junkbotix/build-a-follow-me-robot/chassis-electrical/README.md

Junkbotix Banner

<br>

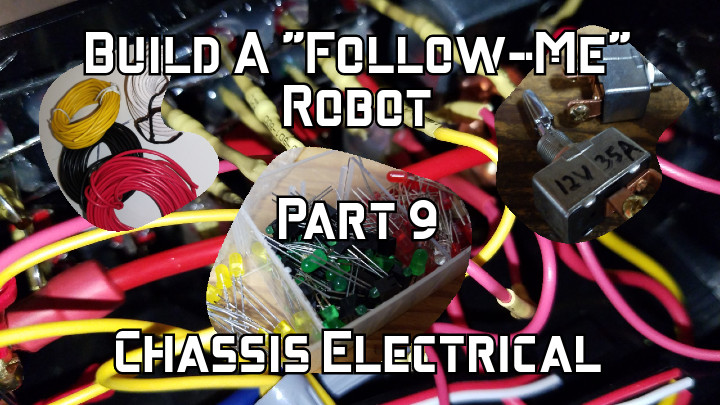
[picture p3: chassis-electrical/images/chassis-electrical-720px.jpg]
Part 9 (https://www.youtube.com/watch?v=LijISf1I_SE)


Check out the latest on this project and other tutorials at the [Junkbotix Channel](https://www.youtube.com/channel/UCNxQ47xBEYjD-mey_lxj9Aw) on Youtube!

<br>

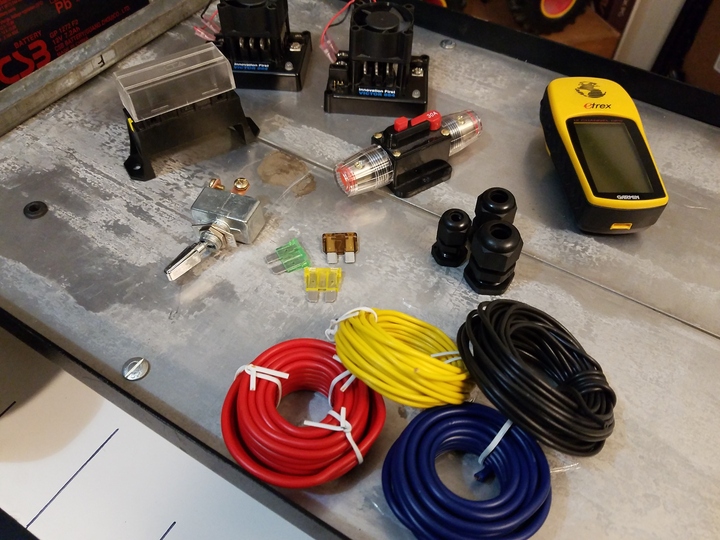
[picture p4: chassis-electrical/images/parts-720px.jpg]
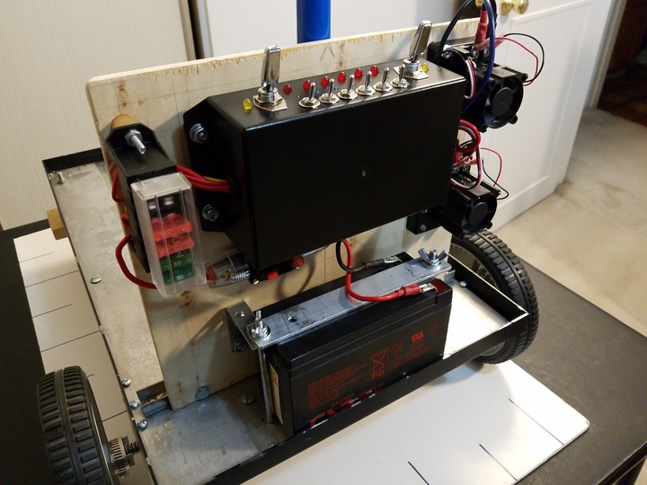
[picture p5: chassis-electrical/images/completed-720px.jpg]
&nbsp;&nbsp;&nbsp;&nbsp;

<br>

Once you have your robot chassis built, you'll need a source of electricity, and ideally a way to control it. Having such a system in place will allow you to more easily develop and maintain the robot's software, while also keeping things neat and tidy, which will help in future maintenance.

But to build such a system, you'll need to plan, design and fabricate it accordingly. How you plan your robot's electrical needs is just as important as its mechanicals, electronics, and code needs. Without a cohesive plan, you might end up with a messy entanglement of wires and tape, making future changes or fixes difficult.

Planning involves coming up with a layout of your electrical system and needs, along with understanding what sub-systems you need to supply power to, and what their voltage and current needs will likely be. How your chassis is built will help determine how you route wiring, and place circuit boards and other parts (indeed, during the design and fabrication of your chassis, you will also need to keep in mind the eventual electrical plan).

This may all sounds like a "chicken-and-egg" problem, but it doesn't have to be. You can design your electrical system first, and then design and fabricate a chassis around that. Or, you can have a rough idea of what you'll later need, and keep it in mind as you build your chassis. You may later need to alter your electrical plans, or even your chassis, but usually, if you have a fairly solid idea in place, any deviations will likely be minor.

## Quicklinks

* [Layout](./layout)
* [Parts](./parts)
  * [Battery](./parts/battery)
  * [Breaker and Fuses](./parts/fuses)
  * [Switches](./parts/switches)
  * [Indicators](./parts/indicators)
  * [Motor Controllers](./parts/motor-controllers)
* [Mechanical](./mechanical)
  * [Panel](./mechanical/panel)
  * [Enclosure](./mechanical/enclosure)
  * [Beacon Support Pole](./mechanical/beacon-pole)
  * [Battery Strap](./mechanical/battery-strap)
* [Wiring](./wiring)

<br>

## Layout
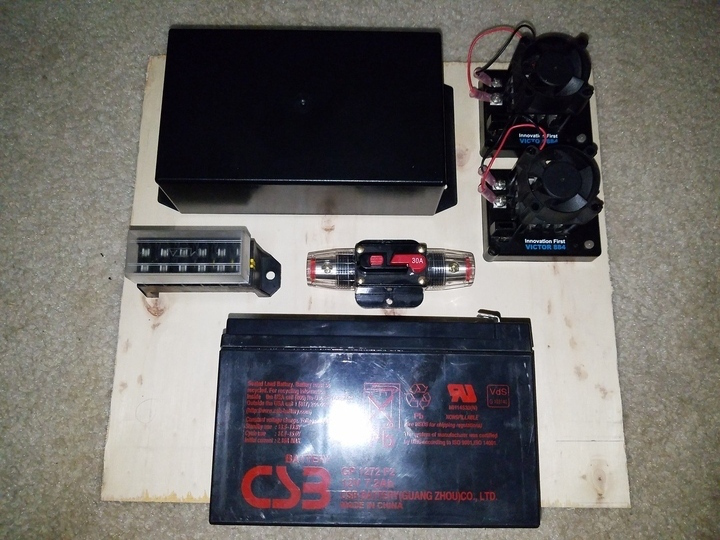
[picture p6: chassis-electrical/layout/images/battery-placement-720px.jpg]
[](./layout)

## Battery (12 VDC, 7Ah)
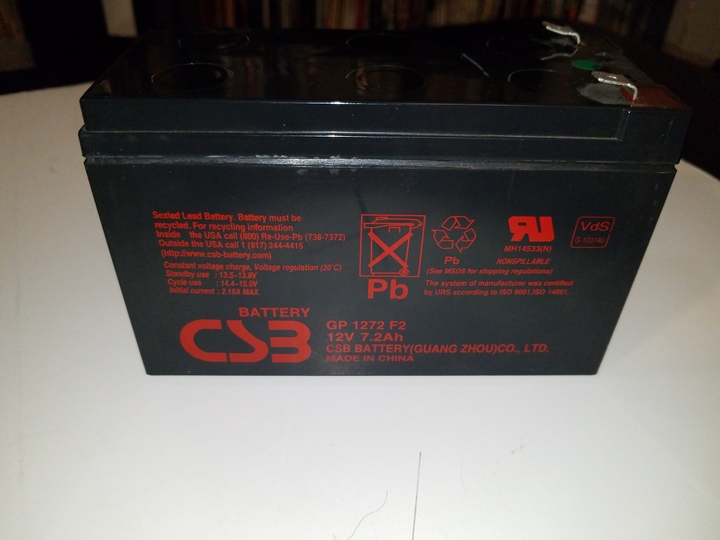
[picture p7: chassis-electrical/parts/battery/images/battery-720px.jpg]
[](./parts/battery)

## Breaker (30A) and Fuses
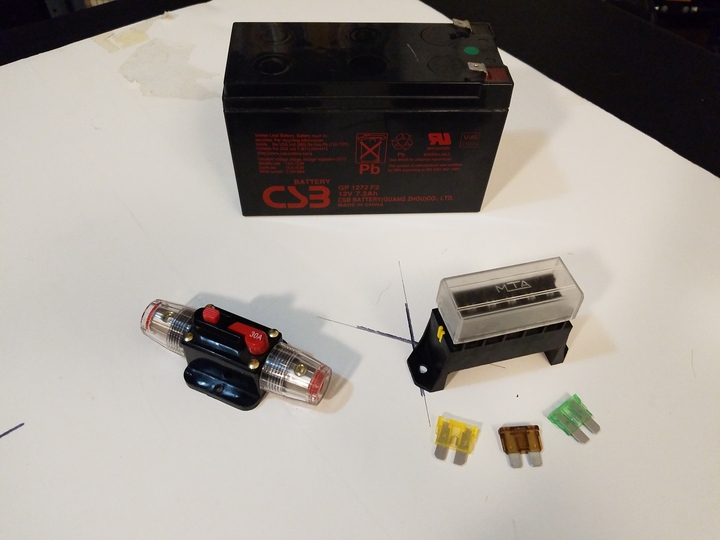
[picture p8: chassis-electrical/parts/fuses/images/breaker-fuses-battery-720px.jpg]
[](./parts/fuses)

## Switches
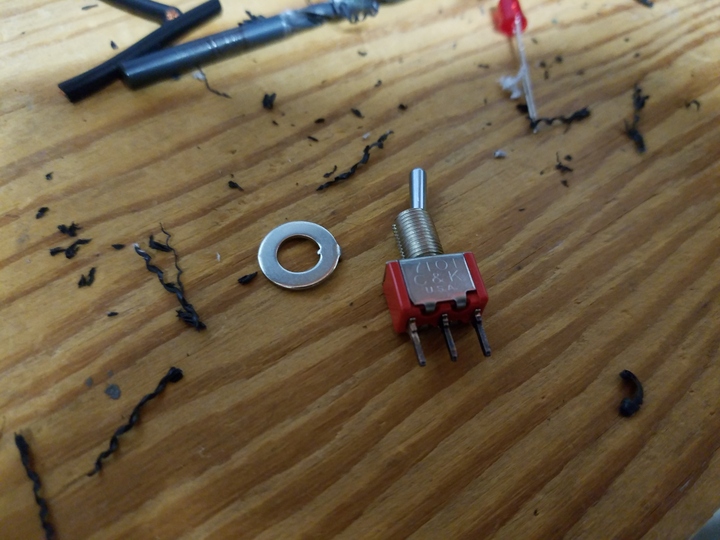
[picture p9: chassis-electrical/parts/switches/images/small-switch-720px.jpg]
[](./parts/switches)

## Indicators
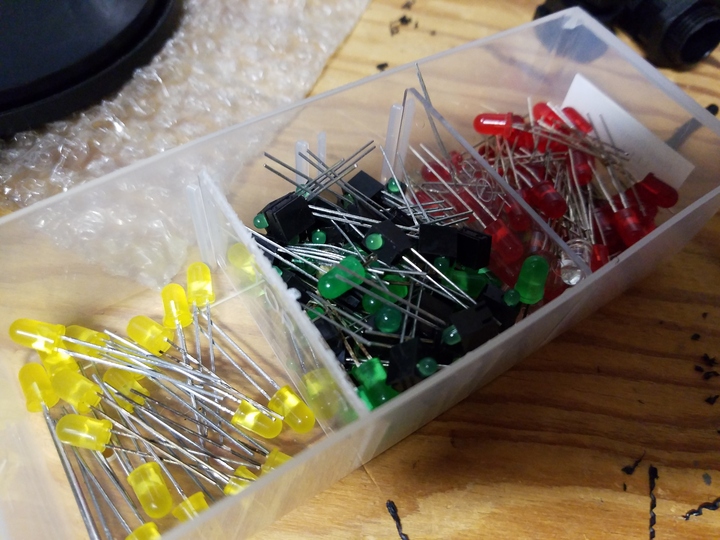
[picture p10: chassis-electrical/parts/indicators/images/leds-720px.jpg]
[](./parts/indicators)

## Motor Controllers
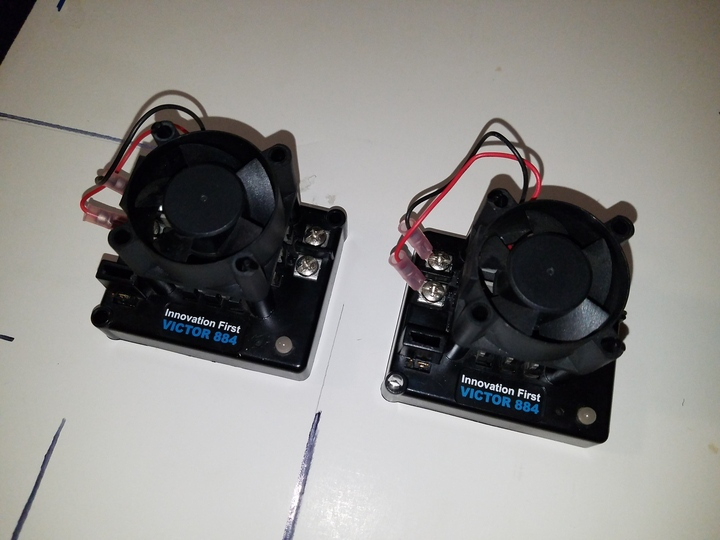
[picture p11: chassis-electrical/parts/motor-controllers/images/motor-controllers-720px.jpg]
[](./parts/motor-controllers)

## Panel
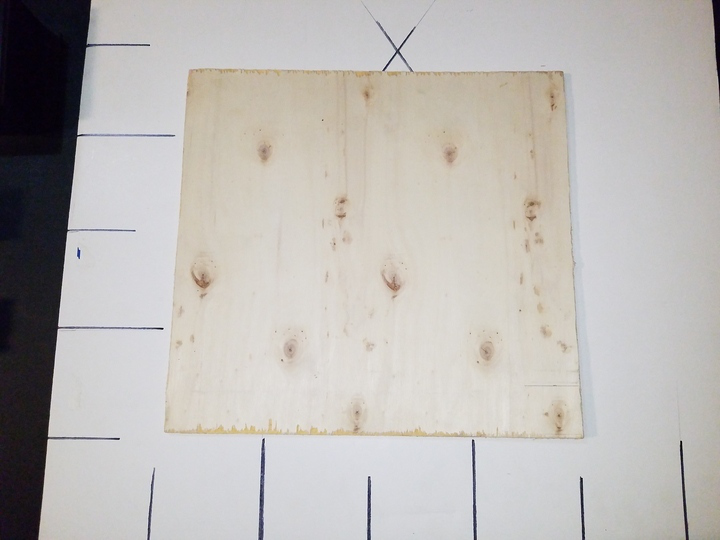
[picture p12: chassis-electrical/mechanical/panel/images/panel-720px.jpg]
[](./mechanical/panel)

## Enclosure
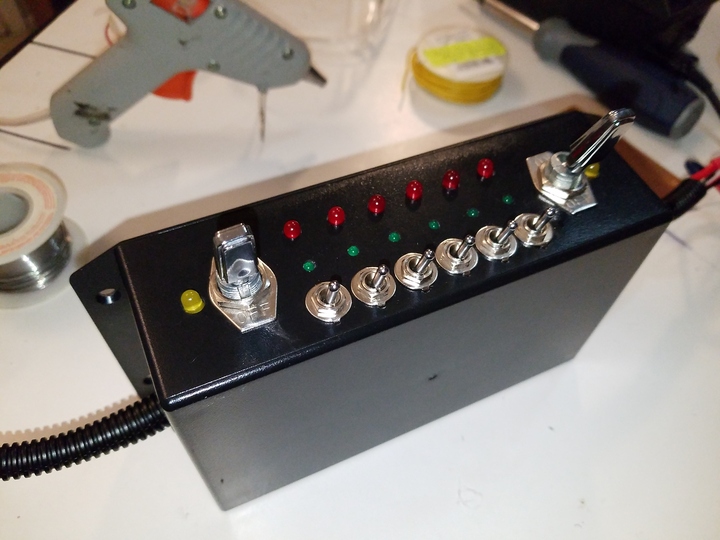
[picture p13: chassis-electrical/mechanical/enclosure/images/completed-enclosure-720px.jpg]
[](./mechanical/enclosure)

## Beacon Support Pole
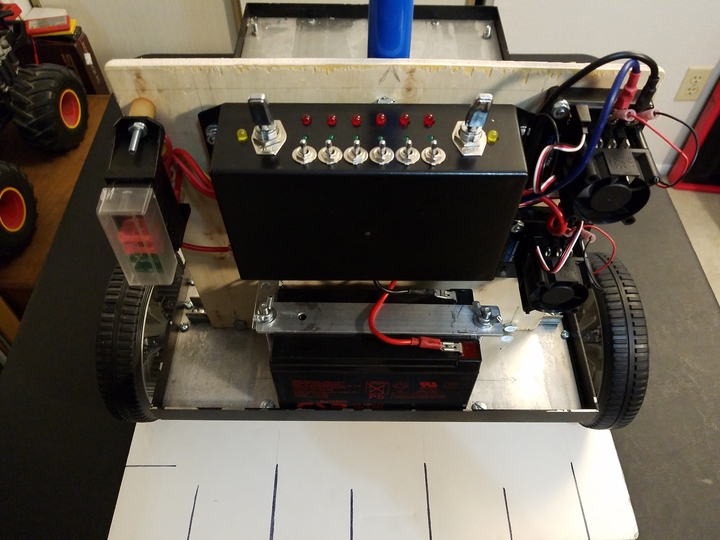
[picture p14: chassis-electrical/mechanical/beacon-pole/images/complete-system-2-720px.jpg]
[](./mechanical/beacon-pole)

## Battery Strap
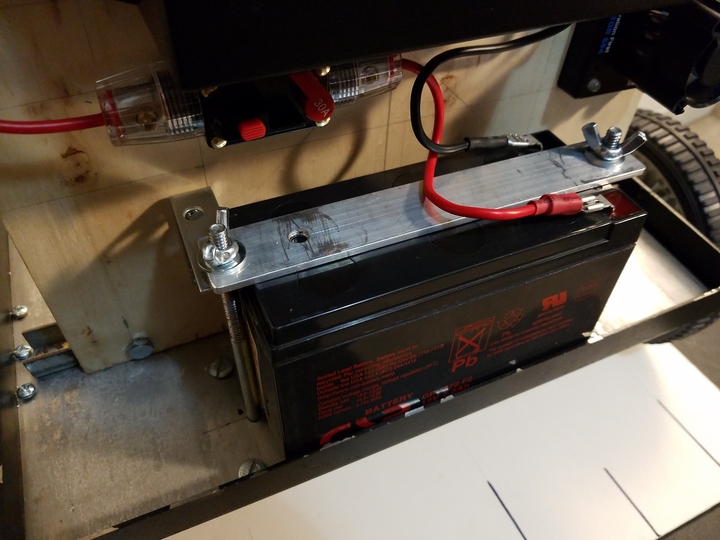
[picture p15: chassis-electrical/mechanical/battery-strap/images/battery-strap-2-720px.jpg]
[](./mechanical/battery-strap)

## Wiring
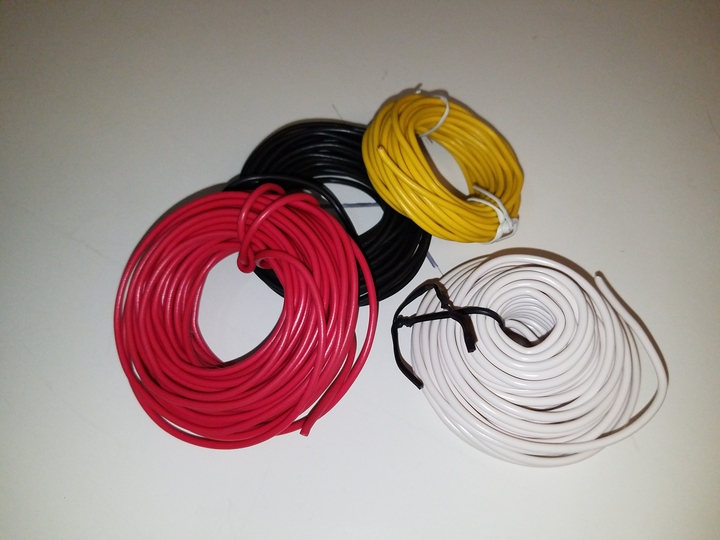
[picture p16: chassis-electrical/wiring/images/16awg-wire-720px.jpg]
[](./wiring)
