junkbotix/build-a-follow-me-robot/motor-control/README.md

Junkbotix Banner

<br>

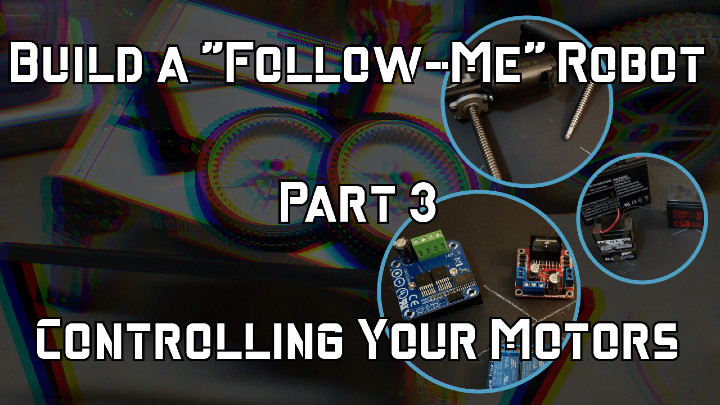
[picture p47: motor-control/images/controlling-motors-720px.jpg]
Part 3 (https://www.youtube.com/watch?v=zeTaibkZ3Tk)


Check out the latest on this project and other tutorials at the [Junkbotix Channel](https://www.youtube.com/channel/UCNxQ47xBEYjD-mey_lxj9Aw) on Youtube!

<br>

## H-Bridges

Useful when direct control of speed and direction of your motor is needed.
<br>

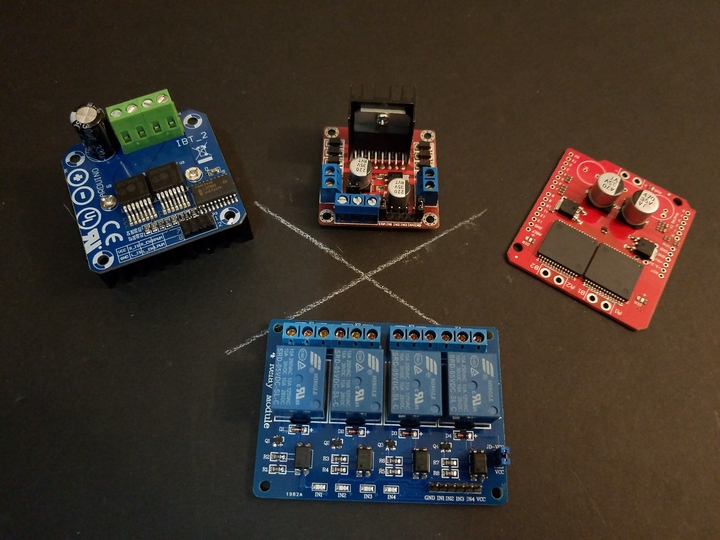
[picture p48: motor-control/h-bridges/images/hbridge-modules-720px.jpg]
H-Bridge Modules
<br>[Various H-Bridge Modules](./h-bridges)

<br>

## RC Electronic Speed Controllers (ESC)

Used when you need or want to use RC (radio control) signals to control your motors, and add a degree of "intelligence", depending on the ESC used.
<br>

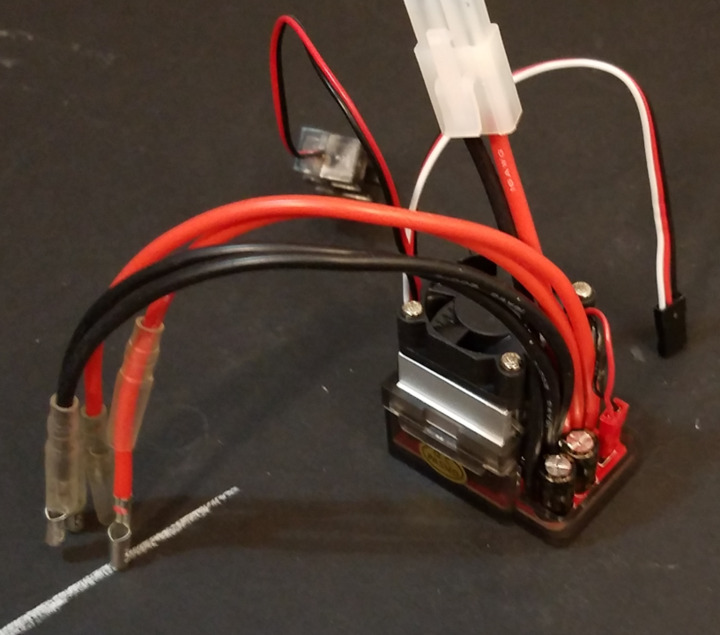
[picture p49: motor-control/esc/images/rc-esc-720px.jpg]
RC ESC
<br>[RC Electronic Speed Controllers (ESC)](./esc)

<br>

## Generic DC Motor Reversible Speed Controller

This kind of controller needs hacking to be useful, but it is inexpensive and powerful.
<br>

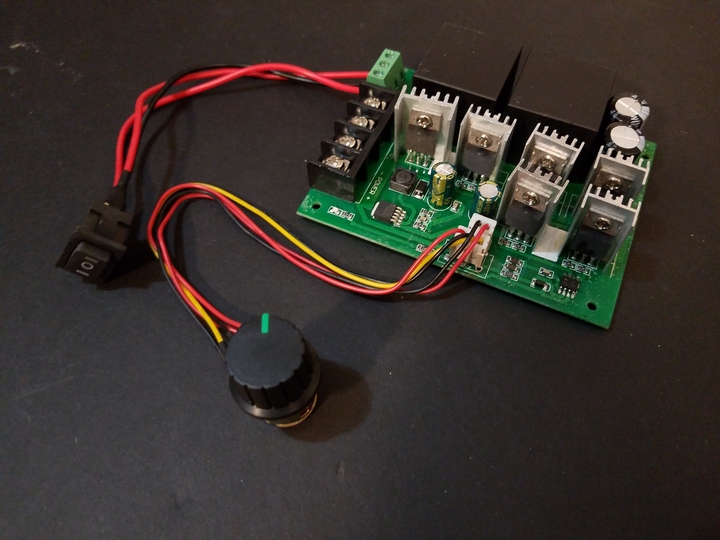
[picture p50: motor-control/generic-controller/images/generic-controller-720px.jpg]
Generic Controller
<br>[Generic DC Motor Controller](./generic-controller)

<br>

## Motor Controllers

If more intelligence is needed, these FRC (FIRST Robotics) controllers can fit the bill; in addition RC PPM/PWM for control, the Jaguar controller can be interfaced using RS-232 and/or CAN over a serial bus, which can be daisy-chained, reducing the number of wires and pins needed for control.
<br>

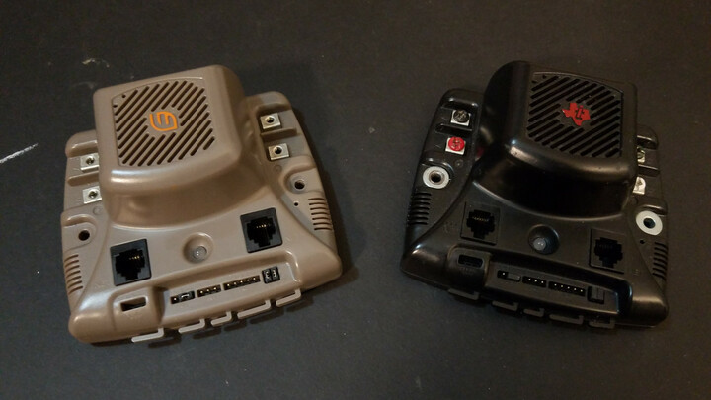
[picture p51: motor-control/jaguar/images/jaguar-controllers-720px.jpg]
MDL-BDC
<br>[MDL-BDC(24) Jaguar (FRC)](./jaguar)

<br>

The Victor-884 and 888 controllers are closer to ruggedized RC ESC controllers, and can't be daisy-chained. Less intelligence, but easier to configure.
<br>

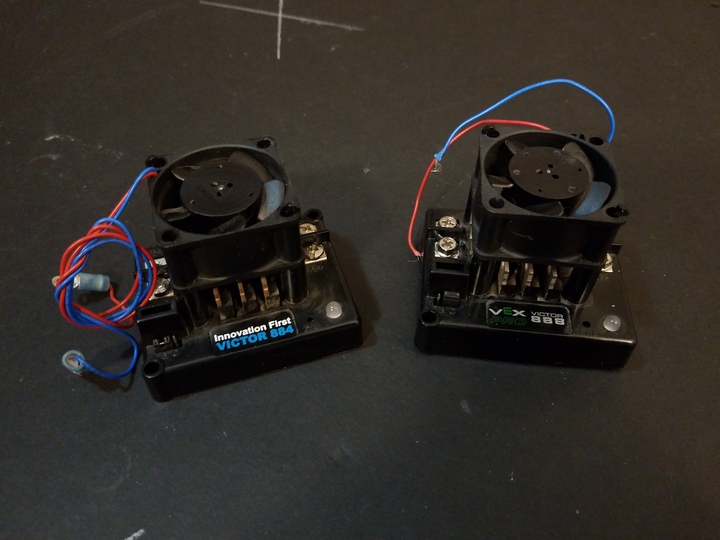
[picture p52: motor-control/victor-884-888/images/victor-884-888-720px.jpg]
Victor-884-888
<br>[Victor-884 and 888 (FRC)](./victor-884-888)
