junkbotix/build-a-follow-me-robot/motor-control/victor-884-888/README.md

Junkbotix Banner

<br>

## Victor-884 and 888 (FRC)

Victor-884 and 888

<br>

The Victor-884 and 888 controllers are closer to ruggedized RC ESC controllers, and can't be daisy-chained. Less intelligence, but easier to configure.

* [IFI Victor-884 Users Manual](./manuals/IFI-Victor-884-Users-Manual.pdf)
* [VexPro Victor-888 User Manual](./manuals/VexPro-Victor-888-User-Manual.pdf)

Like the Jaguar controllers, these are now discontinued, but can also be found sold on the secondary market.

<br>

## More Information

More information about these controllers can be found at [the FIRSTwiki](https://firstwiki.github.io/wiki/victor-884).
