junkbotix/build-a-follow-me-robot/chassis-electrical/mechanical/panel/README.md

Junkbotix Banner

<br>

&nbsp;&nbsp;&nbsp;&nbsp;&nbsp;&nbsp;&nbsp;&nbsp;

Check out the latest on this project and other tutorials at the [Junkbotix Channel](https://www.youtube.com/channel/UCNxQ47xBEYjD-mey_lxj9Aw) on Youtube!

<br>

## The Panel

The purpose of the panel is to ultimately hold all of these parts:

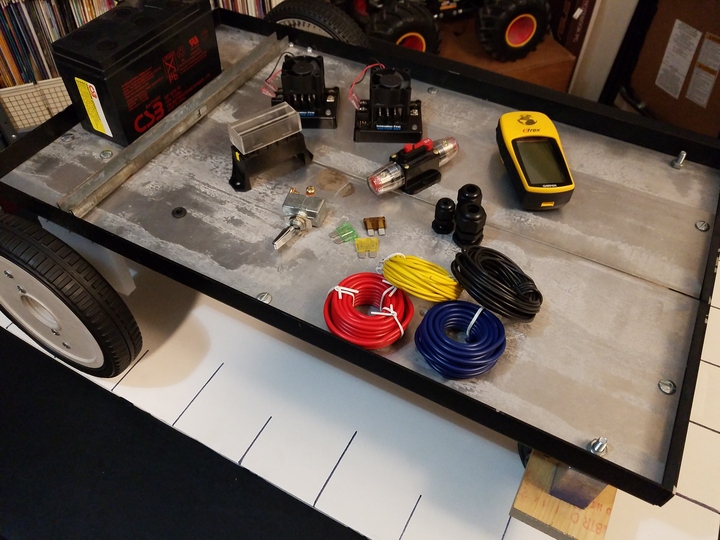
[picture p98: chassis-electrical/mechanical/panel/images/parts-720px.jpg]
Parts


...and others, vertically and out of the way of the cargo area of the chassis. The panel is mounted vertically, between the steel motor bracket bar at the rear of the chassis, and the battery. The beacon support pole, standing vertically from the center of the motor bracket bar, helps to stabilize the panel (while keeping the pole from tipping to the side).

<br>

## The Electrical Bits

The battery is connected to a 30 amp breaker, which is then connected to a fuse block:

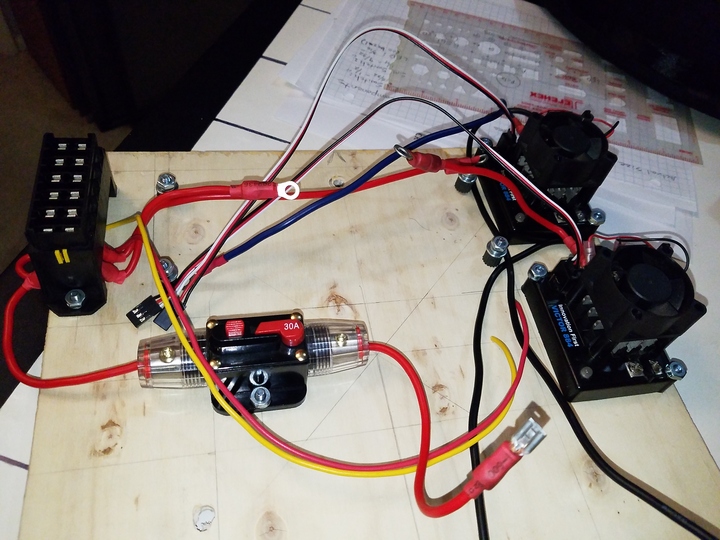
[picture p99: chassis-electrical/mechanical/panel/images/panel-wiring-720px.jpg]
Power Wiring


Please see the section on [wiring](../../wiring) for more details...

<br>

## Final Results

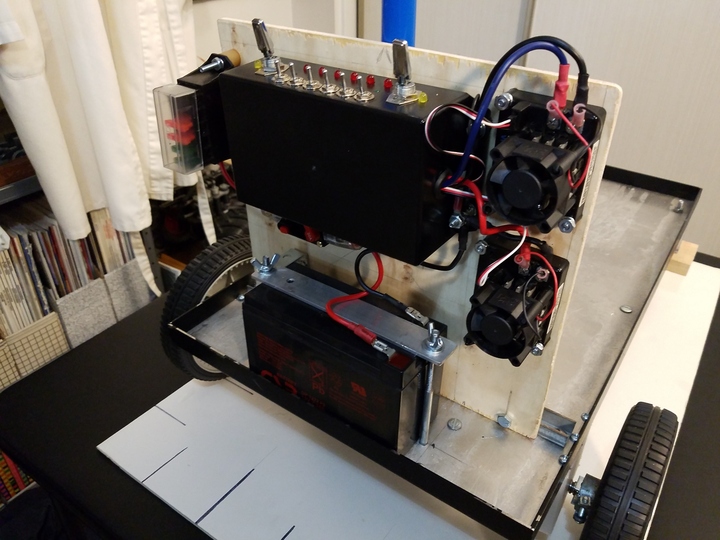
[picture p100: chassis-electrical/mechanical/panel/images/complete-system-2-720px.jpg]
&nbsp;&nbsp;&nbsp;&nbsp;
