junkbotix/build-a-follow-me-robot/motor-control/h-bridges/relay-bridge/README.md

Junkbotix Banner

<br>

## Relay Bridges

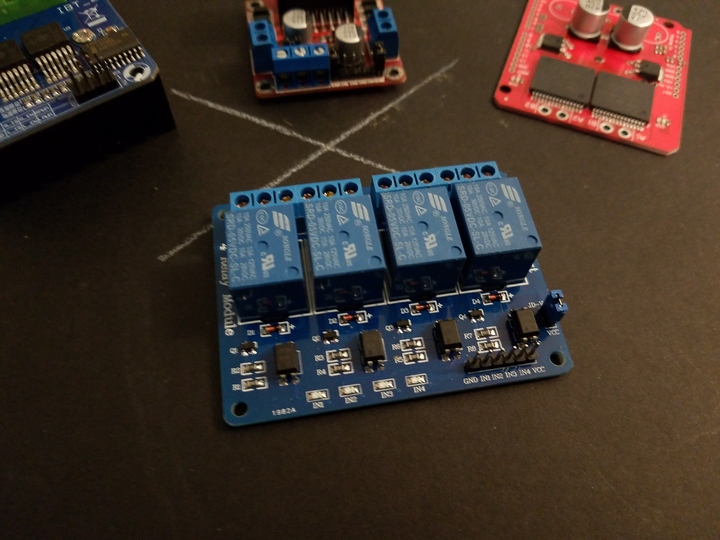
[picture p105: motor-control/h-bridges/relay-bridge/images/relay-module-720px.jpg]
Relay Module


<br>

These relay modules are also widely available and inexpensive. They come in a variety of configurations, having 1, 2, 4, or 8 relays. Each relay is usually a 10A SPDT. Some boards, like this one, are opto-isolated (and as such, usually can be used with 3.3v TTL outputs, too). But not all are.

<br>

## Schematic

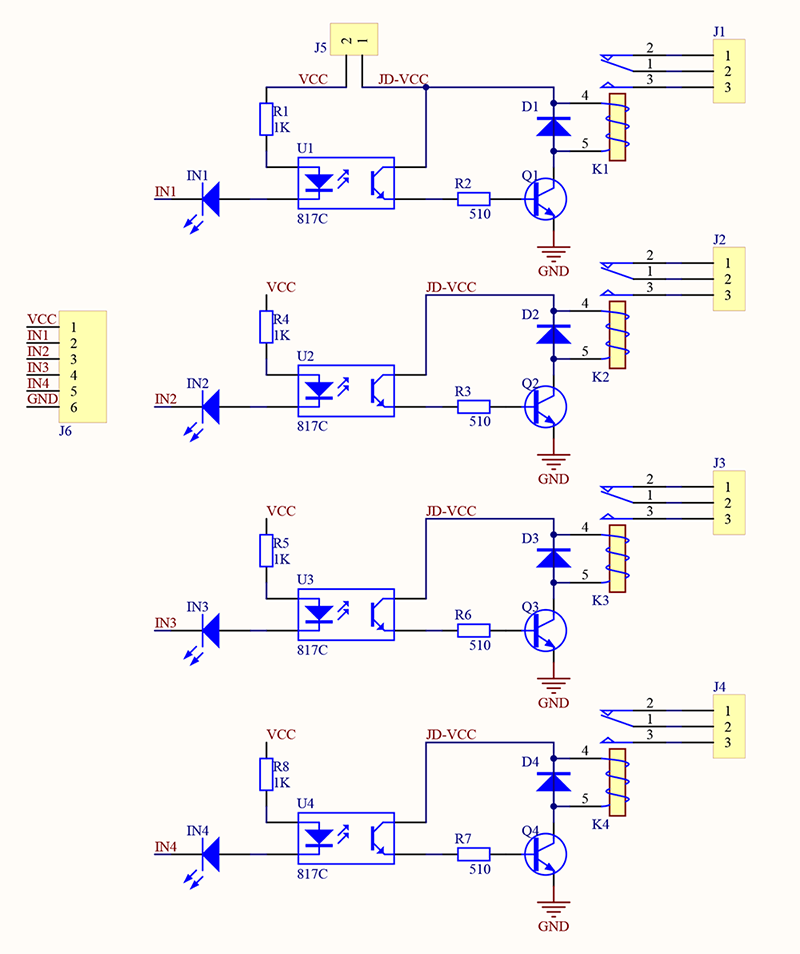
[picture p106: motor-control/h-bridges/relay-bridge/files/4_channel_relay_schematic.png]
4 channel relay module schematic


<br>

## Relay H-Bridge

A pair of the relays can be used to build a simple and controllable h-bridge:

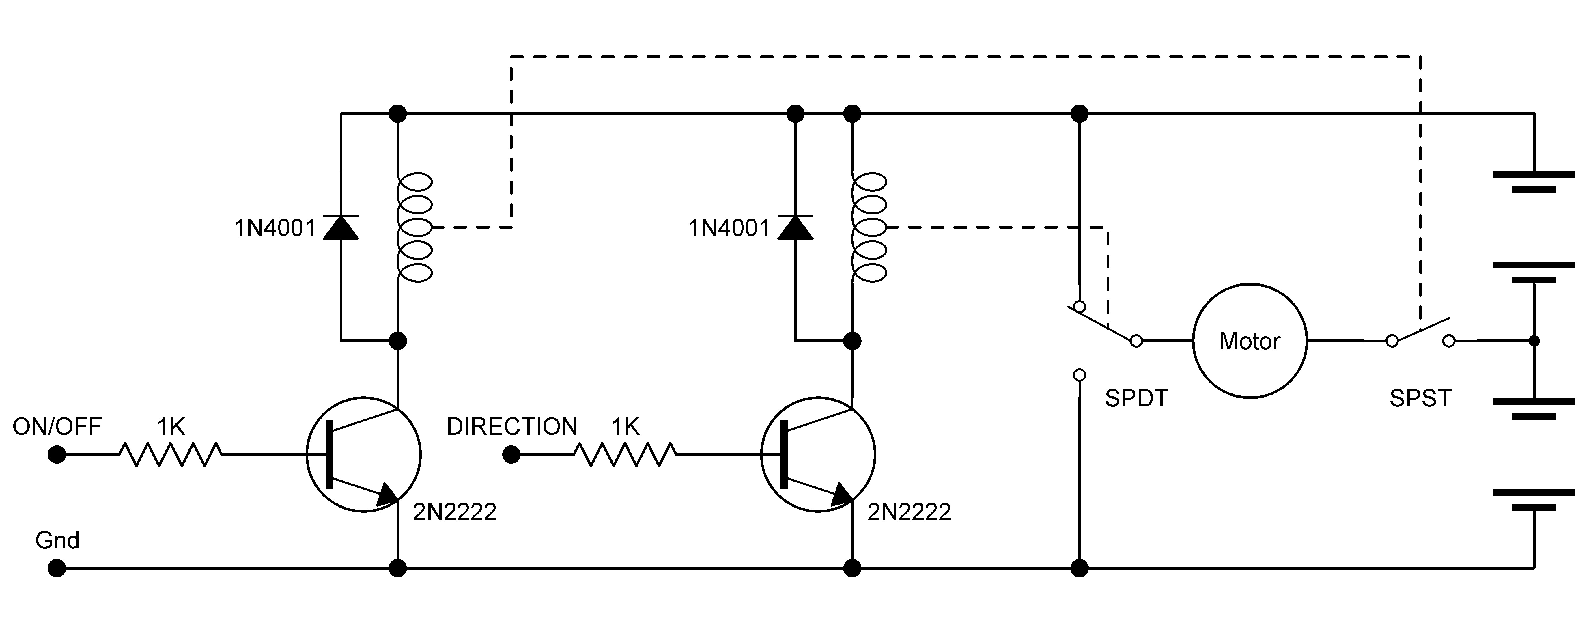
[picture p107: motor-control/h-bridges/relay-bridge/files/bridge-relay-2.jpg]
Transistor Control
<br>
Note the dual-ended motor power supply in the above schematic; compare it with the following (which is also opto-isolated):

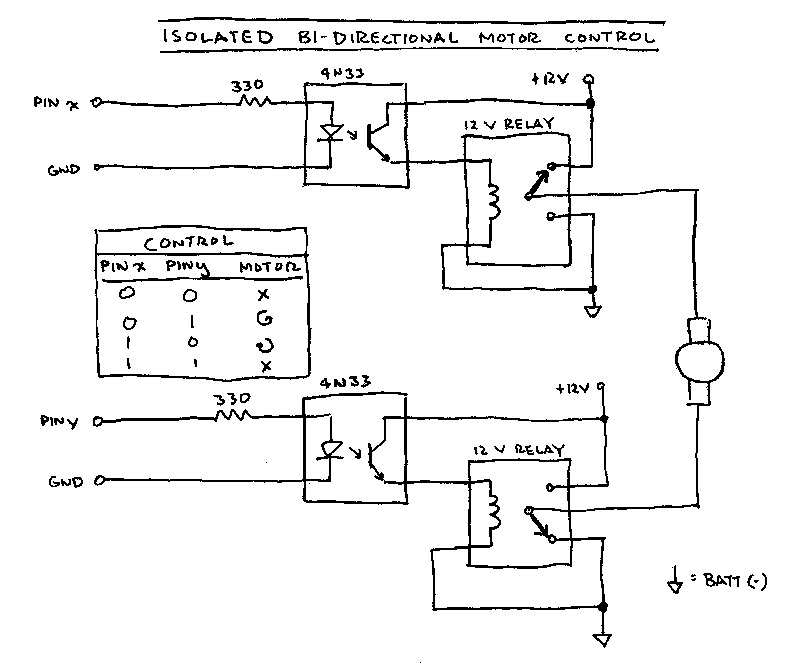
[picture p108: motor-control/h-bridges/relay-bridge/files/isolated-bi-directional-motor-control.jpg]
Opto-Isolator Control


<br>

## Using Bosch Relays

It might also be possible to desolder the relays from such a relay module, and replace them with pairs of Bosch automotive relays, for greater current handling:

Bosch SPDT Relay<br>
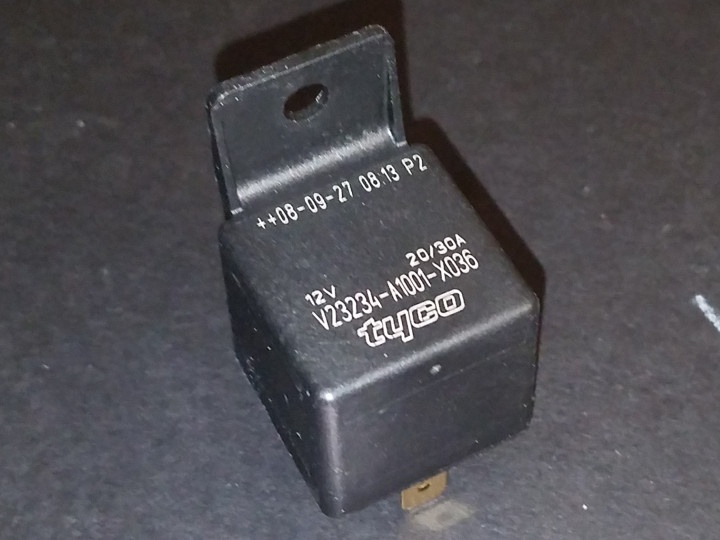
[picture p109: motor-control/h-bridges/relay-bridge/files/bosch-relay-720px.jpg]
Bosch SPDT Relay


Bosch SPDT Relay Pinout<br>
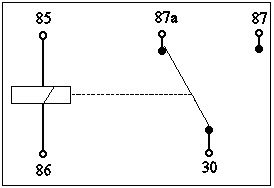
[picture p110: motor-control/h-bridges/relay-bridge/files/bosch-spdt-relay-pinout.jpg]
Bosch SPDT Relay Pinout


Motor Control<br>
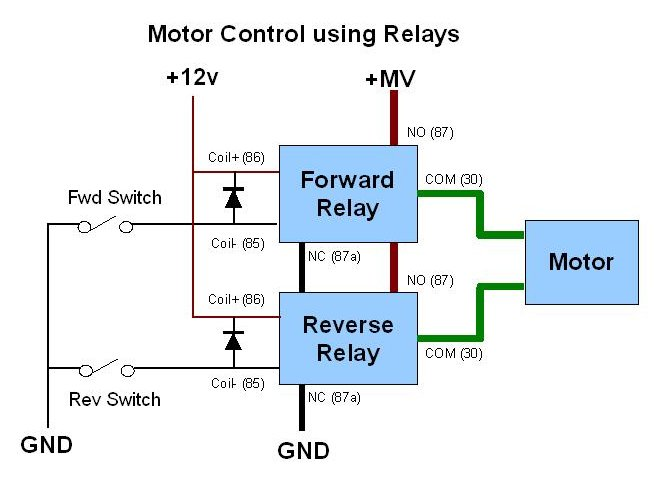
[picture p111: motor-control/h-bridges/relay-bridge/files/bosch-relay-motor-control.jpg]
Bosch SPDT Relay Motor Control


Alternatively, you can just replace the switches with transistors, as before, to control the relays.

<br>

## MOSFET Speed Control (hybrid bridge)

A mosfet can also be used on the low-side of the bridge to control the speed of the motor:

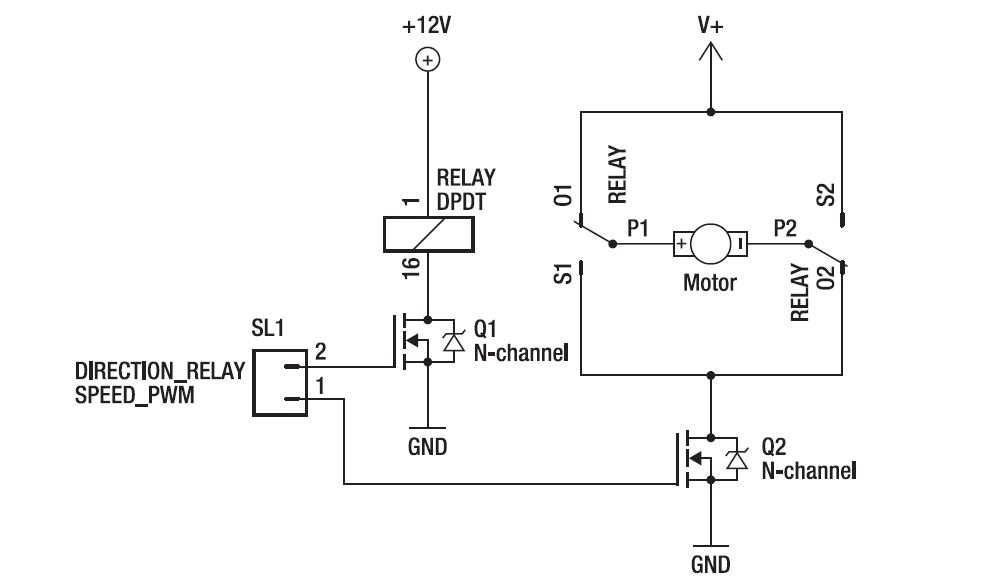
[picture p112: motor-control/h-bridges/relay-bridge/files/dpdt-h-bridge.jpg]
MOSFET Control


Note that this schematic shows a DPDT relay being used, but it isn't common to find such relays with high-current carrying contacts, which is why pairs of SPDT relays are usually used.
