junkbotix/build-a-follow-me-robot/motor-control/jaguar/ti-mdl-bdc24/README.md

Junkbotix Banner

<br>

## Texas Instruments MDL-BDC24 Black Jaguar (FRC)

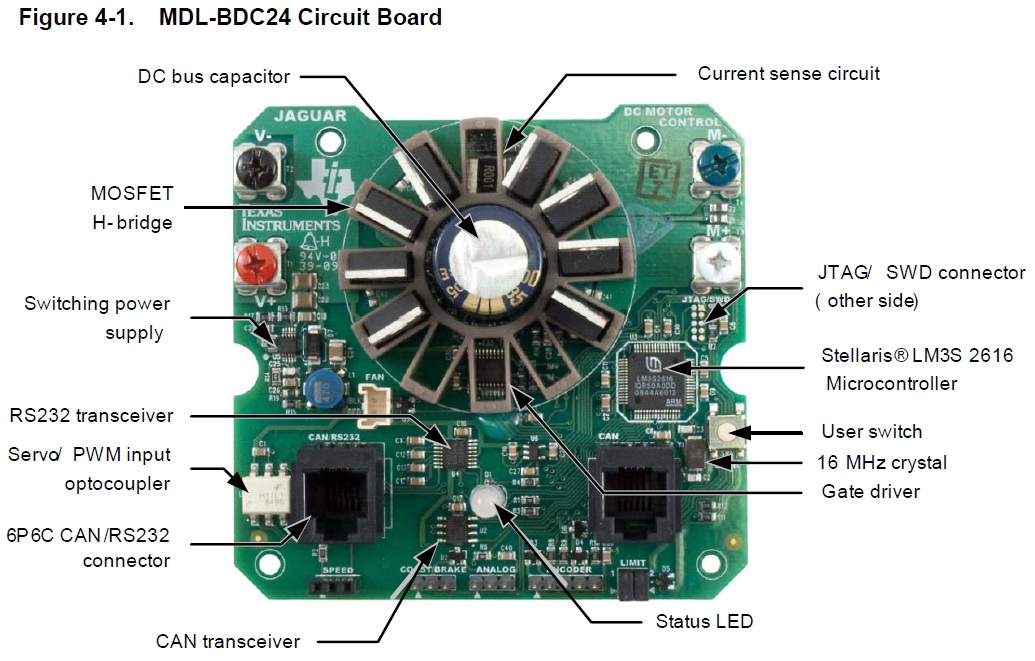
[picture p113: motor-control/jaguar/ti-mdl-bdc24/internals/mdl-bdc24-pcb-parts-layout.jpg]
MDL-BDC


<br>

### Documentation

* [Product Brief (Rev A)](./manuals/mdl-bdc24-product-brief-rev-a.pdf)
* [Datasheet (Rev C)](./manuals/mdl-bdc24-datasheet-rev-c.pdf)
* [Getting Started Guide](./manuals/mdl-bdc24-getting-started-guide.pdf)
* [Users Manual](./manuals/mdl-bdc24-users-manual.pdf)

<br>

### Schematics

* [Embedded Controller, RS-232, CAN](./internals/mdl-bdc24-full-schematic-1.png)
* [Power Supply and H-Bridge](./internals/mdl-bdc24-full-schematic-2.png)
