junkbotix/build-a-follow-me-robot/software/esp32/FMController/README.md

Junkbotix Banner

Check out the latest on this project and other tutorials at the [Junkbotix Channel](https://www.youtube.com/channel/UCNxQ47xBEYjD-mey_lxj9Aw) on Youtube!

<br>

## Controller Firmware for the Junkbotix Build A "Follow-Me" Robot

* [FMController.h](./FMController.h) - Defined constants
* [FMController.ino](./FMController.ino) - Firmware

<br>

### Note:

This ESP32 firmware is currently in an unfinished state, and may or may not work as-is. Certain 3rd-party libraries will also need to be installed to for it to compile. Please consider this a "work-in-progress".

<br>

## License

Unless otherwise specified, all code is licensed as [GPLv3](http://www.gnu.org/licenses/gpl-3.0.en.html) and is Copyright (c) 2021 by Junkbotix

See the [`LICENSE.md`](./LICENSE.md) file for more information.

* If you wish to make a pull request against this repo, go for it, just know that any such request may or may not be used...
* I make no guarantees that any of the code will compile properly or work at all!
* I take no responsibility for your use or misuse of any of this code!
* Caveat emptor!
