junkbotix/build-a-follow-me-robot/motor-control/jaguar/lm-mdl-bdc/README.md

Junkbotix Banner

<br>

## Luminary Micro MDL-BDC Gray Jaguar (FRC)

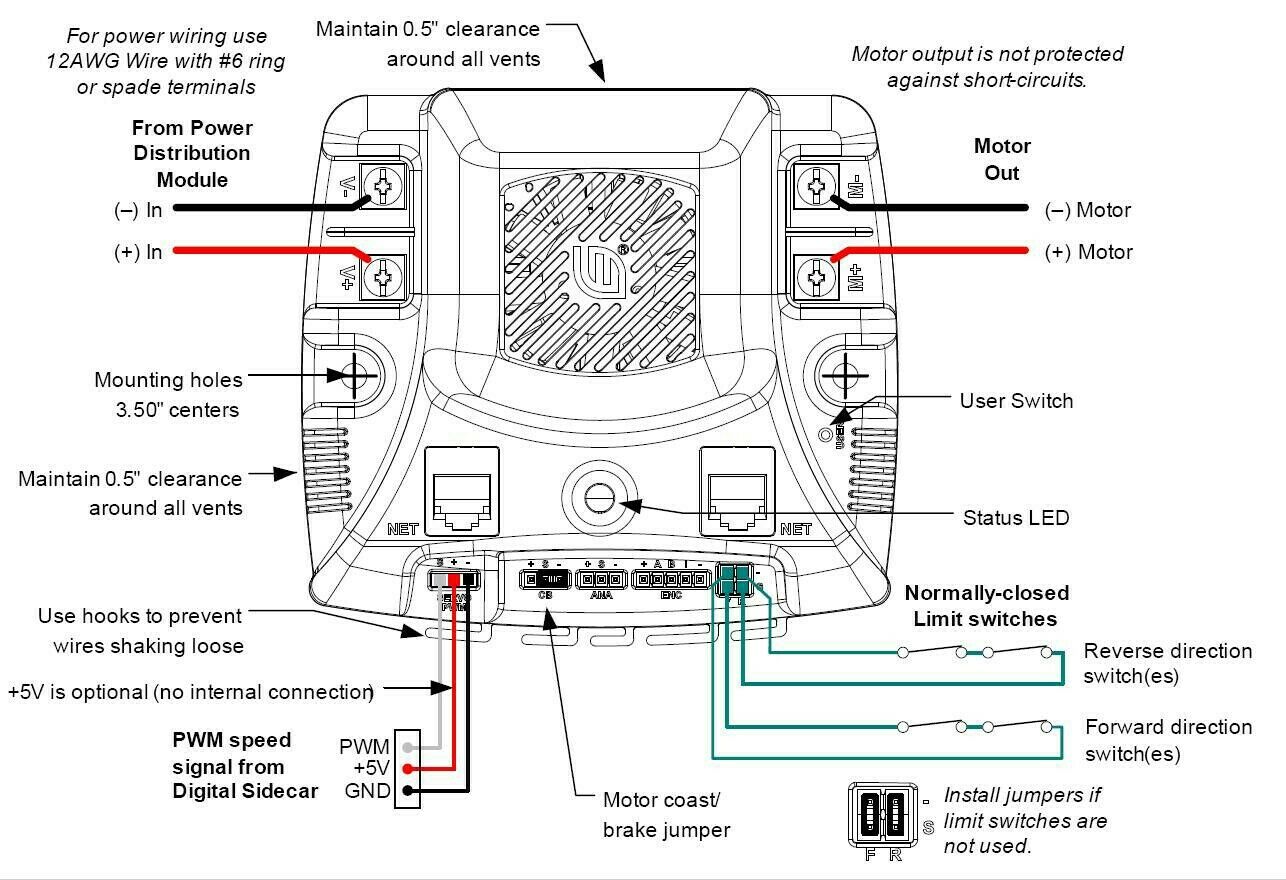
[picture p114: motor-control/jaguar/lm-mdl-bdc/images/connections.jpg]
MDL-BDC


[Getting Started Guide](./manual/mdl-bdc-frc-2009-getting-started-guide.pdf)
