junkbotix/build-a-follow-me-robot/controller/files/general-auto-reset.jpg

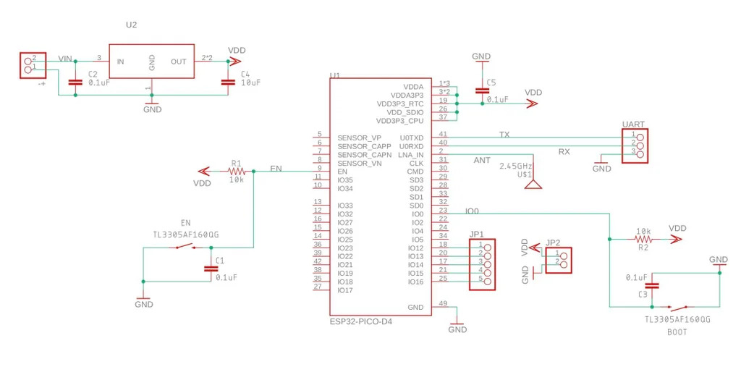
controller/files/general-auto-reset.jpg
