junkbotix/build-a-follow-me-robot/motor-control/h-bridges/monster-moto-shield/files/schematic.png

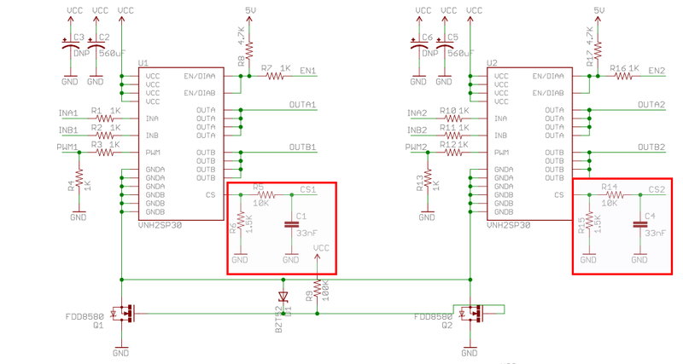
motor-control/h-bridges/monster-moto-shield/files/schematic.png
