junkbotix/build-a-follow-me-robot/motor-control/jaguar/ti-mdl-bdc24/internals/mdl-bdc24-full-schematic-2.png

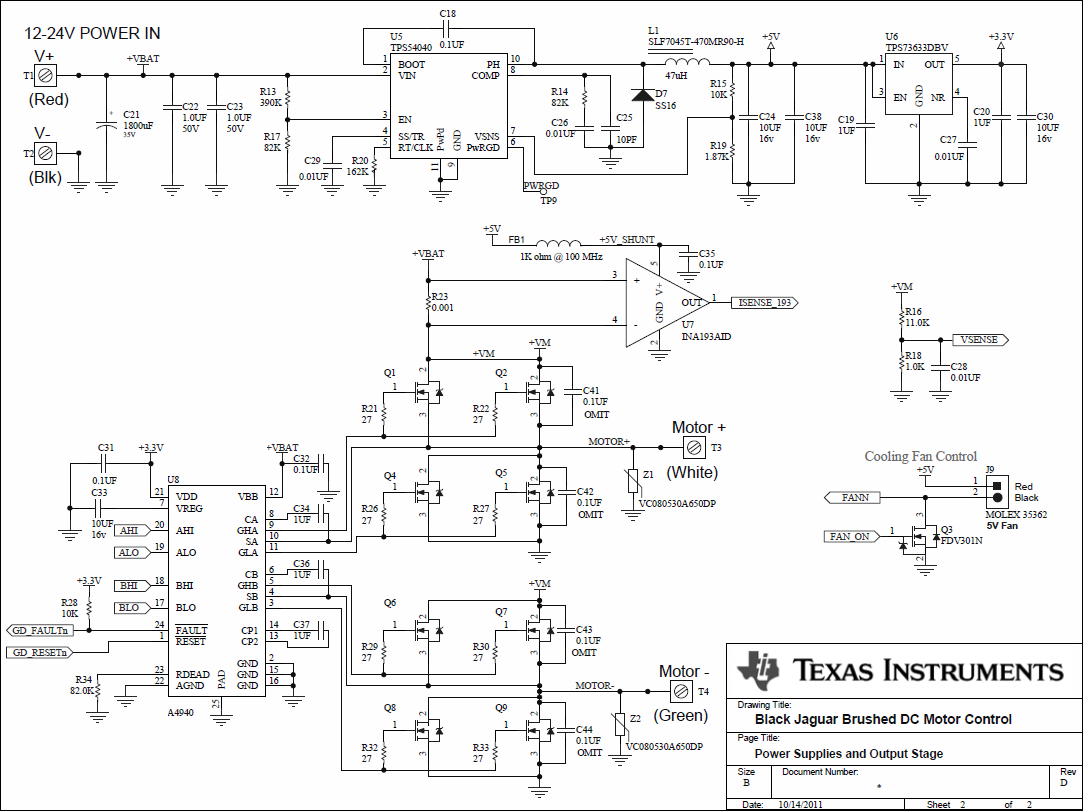
motor-control/jaguar/ti-mdl-bdc24/internals/mdl-bdc24-full-schematic-2.png
