junkbotix/build-a-follow-me-robot/chassis-electrical/parts/README.md

Junkbotix Banner

<br>

Parts

Check out the latest on this project and other tutorials at the [Junkbotix Channel](https://www.youtube.com/channel/UCNxQ47xBEYjD-mey_lxj9Aw) on Youtube!

<br>

## Parts

There are many different parts that can make up a robot's chassis electrical system, but the most important ones are the battery(s) and fuses (and/or breakers). The others aren't strictly needed, but you may want to give them consideration.

While they can make the design more complicated, they also introduce useful features which can help in future development and maintenance of your robot. Each of these parts will be detailed in its own separate section:

<br>

## Quicklinks

* [Battery](./battery)
* [Breaker and Fuses](./fuses)
* [Switches](./switches)
* [Indicators](./indicators)
* [Motor Controllers](./motor-controllers)

<br>

## Battery (12 VDC, 7Ah)
[](./battery)

## Breaker (30A) and Fuses
[](./fuses)

## Switches
[](./switches)

## Indicators
[](./indicators)

## Motor Controllers
[](./motor-controllers)
