junkbotix/build-a-follow-me-robot/motor-control/h-bridges/monster-moto-shield/setup/single-board-dual-motor-connections.jpg

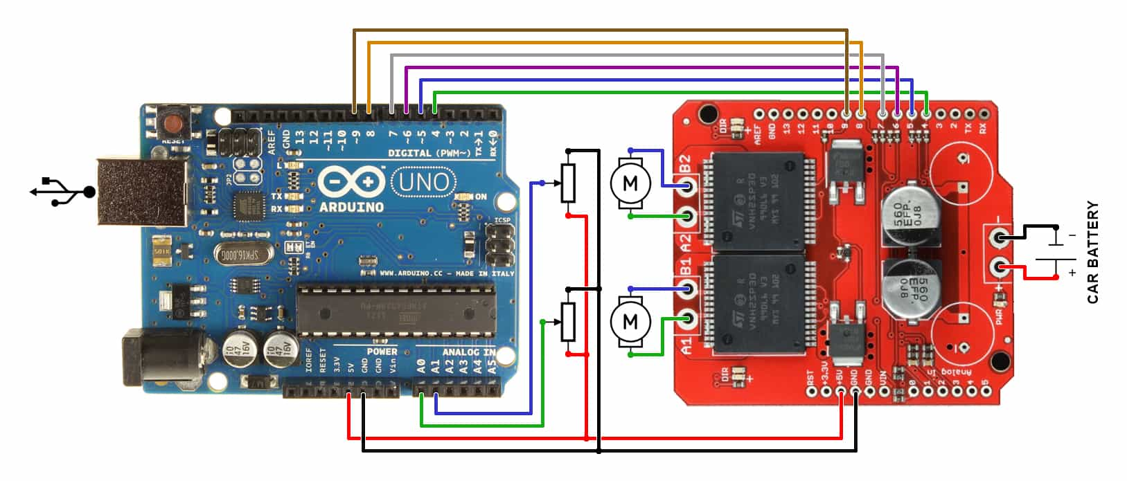
motor-control/h-bridges/monster-moto-shield/setup/single-board-dual-motor-connections.jpg
