junkbotix/build-a-follow-me-robot/motor-control/h-bridges/l298-module/files/reference-schematic.pdf

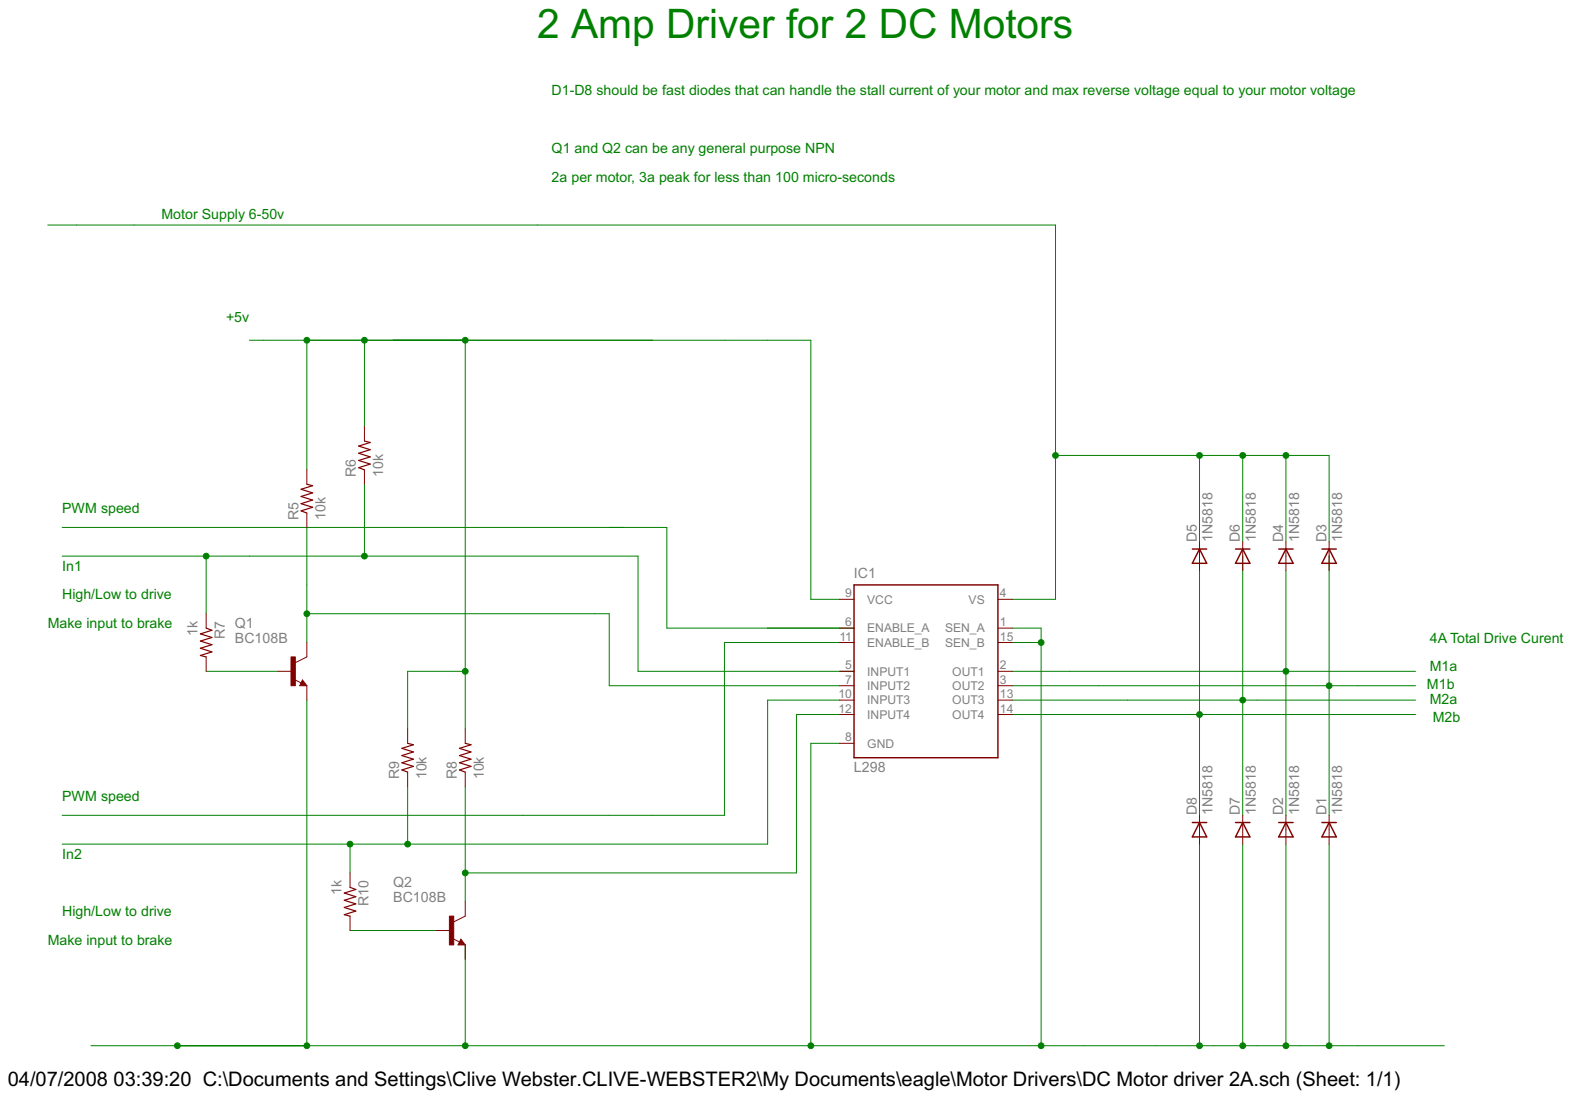
[picture p176: page 1]

2 Amp Driver for 2 DC Motors

D1-D8 should be fast diodes that can handle the stall current of your motor and max reverse voltage equal to your motor voltage

Q1 and Q2 can be any general purpose NPN

2a per motor, 3a peak for less than 100 micro-seconds

High/Low to drive Make input to brake

04/07/2008 03:39:20 C:\Documents and Settings\Clive Webster.CLIVE-WEBSTER2\My Documents\eagle\Motor Drivers\DC Motor driver 2A.sch (Sheet: 1/1)
