junkbotix/build-a-follow-me-robot/software/esp32/FMController/FMController.ino

/**
 * Build A "Follow-Me" Robot: Part 11 - Software
 *
 * FMController.ino - Firmware for the Junkbotix Build A "Follow-Me" Robot 
 * Copyright (c) 2021 by Junkbotix 
 * Licensed under the GNU Public License (GPL) Version 3 
 * http://www.gnu.org/licenses/gpl-3.0.en.html 
 */ 

// Various defined constants for controller and state machine logic
#include "FMController.h"

// Instantiate robot and client model objects
Junkbotix_Robot FMRobot(WAIT_FOR_GPS);
Junkbotix_Client FMClient();

// Instantiate on-board webserver
Junkbotix_Webserver FMWebserver;

// Instantiate motor controller interface objects
Junkbotix_Victor884 LeftMotor(LEFT_MOTOR);
Junkbotix_Victor884 RightMotor(RIGHT_MOTOR);

// Instantiate the "blinking" beacon style object
Junkbotix_Beacon_Style BlinkBeaconStyle;

// Instantiate the "flashing" beacon style object
Junkbotix_Beacon_Style FlashBeaconStyle;

// Instantiate the "breathing" beacon style object
Junkbotix_Beacon_Style BreathBeaconStyle;

// Instantiate beacon interface objects
Junkbotix_Beacons VisibleBeacon(VIS_BEACON, 0);
Junkbotix_Beacons AudibleBeacon(AUD_BEACON, 1);

// Instantiate Etrex interface object
Junkbotix_Etrex EtrexGPS(ETREX_TX, ETREX_RX);

void setup() {
    // Initialize hardware serial port
    Serial.begin(115200);

    // Set up the "blinking" beacon style object
    BlinkBeaconStyle.setName("blink");

    // Set up the "flashing" beacon style object
    FlashBeaconStyle.setName("flash");
    FlashBeaconStyle.setRepeat(2);
    FlashBeaconStyle.setOnDelay(75);
    FlashBeaconStyle.setOffDelay(500);
    FlashBeaconStyle.setPauseDelay(1000);

    // Set up the "breathing" beacon style object
    BreathBeaconStyle.setName("breath");
    BreathBeaconStyle.setStep(1);
    BreathBeaconStyle.setOnDelay(5);
    BreathBeaconStyle.setOffDelay(5);
}

void loop() {
    //debug_blink();

    switch (FMRobot.getState()) {
        case WAIT_FOR_GPS:
            if (true) {
                // If the GPS is ready, flash and beep beacons 2x
                VisibleBeacon.tick(FlashBeaconStyle);
                AudibleBeacon.tick(FlashBeaconStyle);
                
                if (VisibleBeacon.isPaused() && AudibleBeacon.isPaused()) {
                    Serial.println("GPS ready...");
                    FMRobot.setState(INIT_WEB_SERVER);
                }
            } else {
                // If the GPS isn't ready, fade in/out the LED beacon (breathing)
                VisibleBeacon.tick(BreathBeaconStyle);
            }

            break;

        case INIT_WEB_SERVER:
            // Initialize the webserver, then wait for a connection
            FMWebserver.init();
            FMRobot.setState(WAIT_FOR_STATION_CONNECT);
            break;

        case WAIT_FOR_STATION_CONNECT:
            if (FMWebserver.isConnected()) {
                // Acknowledge station connect
                FMRobot.setState(ACK_STATION_CONNECT);
            } else {
                // If a client is not connected yet, fade in/out the LED beacon (breathing)
                VisibleBeacon.tick(BreathBeaconStyle);
            }
            break;

        case ACK_STATION_CONNECT:
            // When a client (station) connects to the AP, flash/beep beacons 2x
            VisibleBeacon.tick(FlashBeaconStyle);
            AudibleBeacon.tick(FlashBeaconStyle);

            if (VisibleBeacon.isPaused() && AudibleBeacon.isPaused()) {
                FMRobot.setState(RESET_BEACONS);
            }
            break;

        case RESET_BEACONS:
            // Turn off all of the beacons
            VisibleBeacon.off();
            AudibleBeacon.off();

            // Then start checking for commands from the client, first the E-STOP        
            FMRobot.setState(CHECK_CLIENT_ESTOP);
            break;

        case CHECK_CLIENT_ESTOP:
            // By default, we need to get the client's last reported position
            FMRobot.setState(GET_CLIENT_GEO_POSITION);
            // But if an E-STOP request occurred, set a state to initialize full halt mode
            if (FMWebserver.isEStopped()) FMRobot.setState(INIT_HCF_HALT);
            break;
        
        case GET_CLIENT_GEO_POSITION:
            /*
            Read the client's GPS data (moving average filtered on client):
                Latitude
                Longitude
                Heading 
            Save the client's GPS data
            */
            FMRobot.setState(GET_ROBOT_GEO_POSITION);
            break;

        case GET_ROBOT_GEO_POSITION:
            /*
            Read Etrex (robot's) GPS data:
                Latitude
                Longitude
                Heading 
            Filter using moving average
            Save the robot's GPS data
            */
            FMRobot.setState(UPDATE_ROBOT_NAVIGATION);
            break;

        case UPDATE_ROBOT_NAVIGATION:
            FMRobot.setState(HANDLE_MOVEMENT);
            /*
            Get the robot's GPS data (Latitude, Longitude, Heading)
            Get the client's GPS data (Latitude, Longitude, Heading)
            
            Calculate  the robot's heading and distance to the client position

            If the distance is under the set threshold:
                Set the state to HANDLE_ARRIVAL
            */
            break;

        case HANDLE_MOVEMENT:
            // Update the robot's motor settings to move it toward the client's position
            FMRobot.setState(CHECK_CLIENT_ESTOP);
            break;

        case HANDLE_ARRIVAL:
            /*
            Flash and beep the beacons 4x
            
            Notes: 
            1. We probably need a new beacon for this
            2. How to properly "handle arrival" once?
            */
            FMRobot.halt();
            FMRobot.setState(CHECK_CLIENT_ESTOP);
            break;

        case INIT_HCF_HALT:
            // Set a message back to client that halting has occurred, then HALT
            FMWebserver.setClientMessage("!!! E-STOP - HALTED !!!");
            FMRobot.setState(HCF_HALT);
            break;

        case HCF_HALT:
            // Break statement purposefully omitted...

        default:
            /*
            If halting, or anything that doesn't match a previously defined 
            state, halt all robot operations
            */
            FMRobot.halt();
            VisibleBeacon.tick(BlinkBeaconStyle);

            // At this point power must be cycled (reset)
    }
}
