junkbotix/build-a-follow-me-robot/(commit log)

2021-02-01 Updates to support Part 2 - Selecting Your Motors and Batteries
2021-03-12 Updates to support follow me robot tutorial - Completed chassis assembly
2021-04-02 Updates to support follow me robot tutorial - Chassis Electrical
2021-04-24 Initial framework and supporting files
2021-04-28 implementing switch-case state machine code and stubs
2021-06-05 Updates to controller, webserver, and beacon classes to work properly with ESP32 hardware functionality and more...
2021-06-10 Mods to get beacons working properly...but now state machine fails randomly when audio beacon is turned .off()???
    [FMController.ino]
2021-06-14 Updates to fix beacon and general controller state machine operation. Also updated controller web page to allow sending of fake GPS coordinates and heading. Plus general cleanup.
    [FMController.ino]
